jrleeman/WildfireTiltLogger/README.md

# WildfireTiltLogger

Tilt meter logger using the wildfire board as a base.
