jrleeman/WildfireTiltLogger/docs/box_drill_pattern.jpg

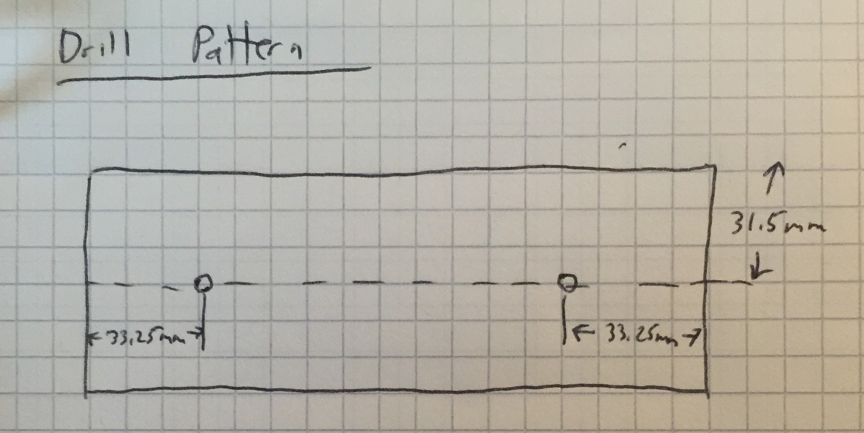
docs/box_drill_pattern.jpg
