jrleeman/WildfireTiltLogger/docs/connector_pinouts.jpg

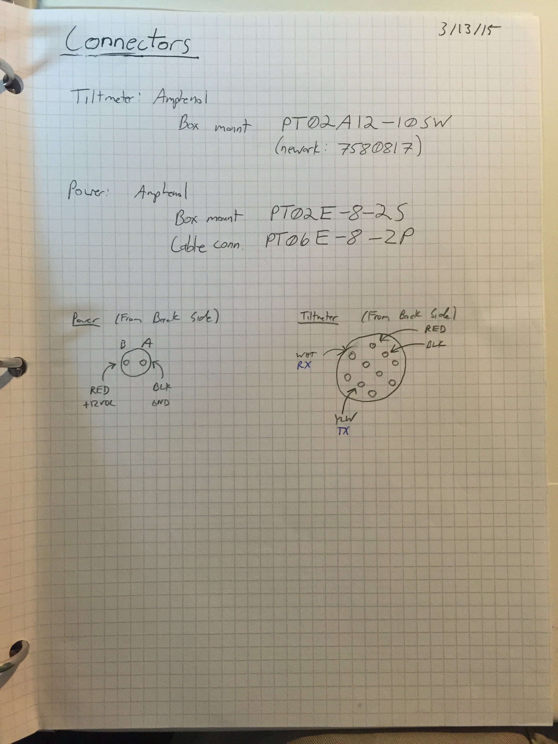
docs/connector_pinouts.jpg
