jrleeman/WildfireTiltLogger/(commit log)

2015-04-14 Add code to have a simulated tilt meter from a second Arduino
2015-04-22 Add error lights and light to setup routine
    [Tilt_Logger_Hourly_CallResp.ino]
2015-04-22 Add error checking on writes and test
    [Tilt_Logger_Hourly_CallResp.ino]
2015-05-04 Fix GPS serial bug
    [Tilt_Logger_Hourly_CallResp.ino]
2015-05-04 Change error code numbering
    [Tilt_Logger_Hourly_CallResp.ino]
2015-05-05 Change input voltage range to 7-23 VDC
2015-06-01 Fix startup race in TinyWDT
    [Tilt_Logger_Daily_CallResp.ino]
